BadgePiratesLLC/CactusCon-12/DOCS/ProjectNeoRogue_Back.png

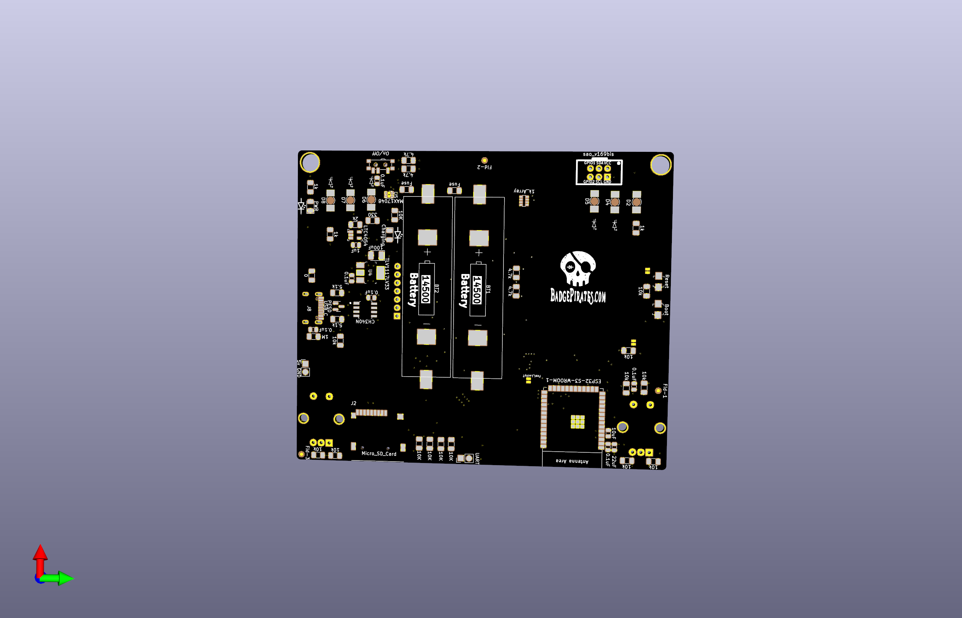
DOCS/ProjectNeoRogue_Back.png
