BadgePiratesLLC/CactusCon-12/DOCS/ProjectNeoRogue_Front.png

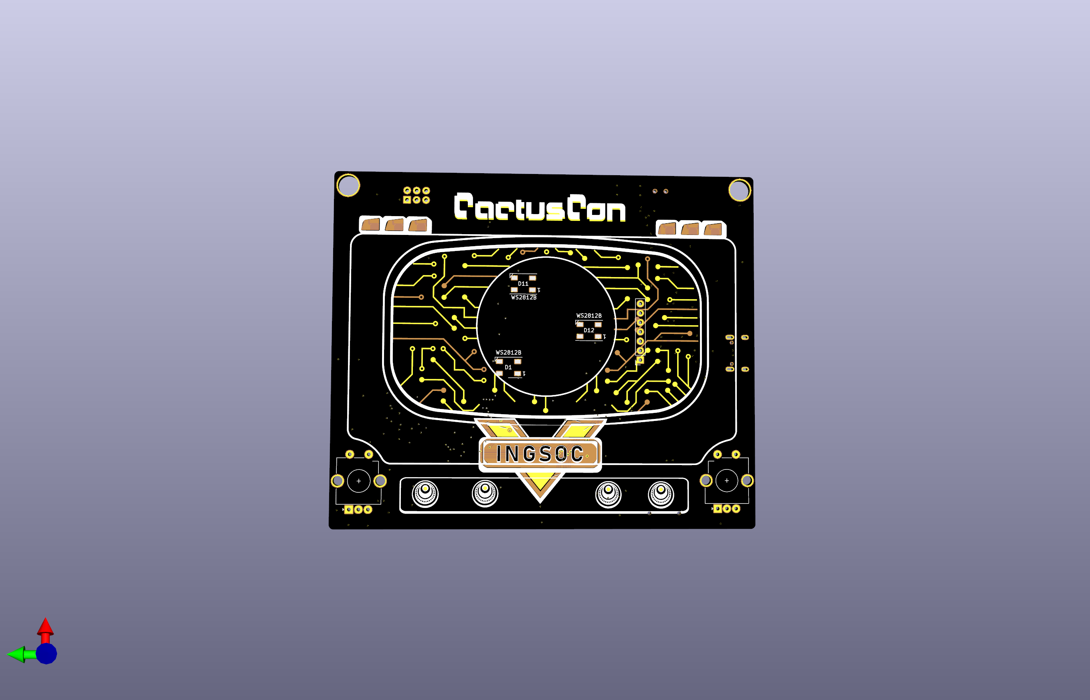
DOCS/ProjectNeoRogue_Front.png
