BadgePiratesLLC/CactusCon-12/Artwork/Export/.svg2shenzhen-cache/images/B.Cu_g3.png

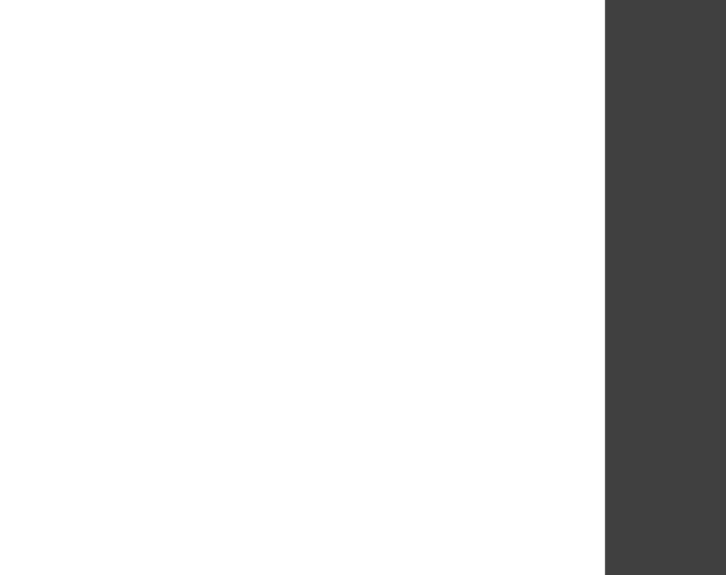
Artwork/Export/.svg2shenzhen-cache/images/B.Cu_g3.png
