BadgePiratesLLC/CactusCon-12/Artwork/Export/.svg2shenzhen-cache/images/Dwgs.User_g9.png

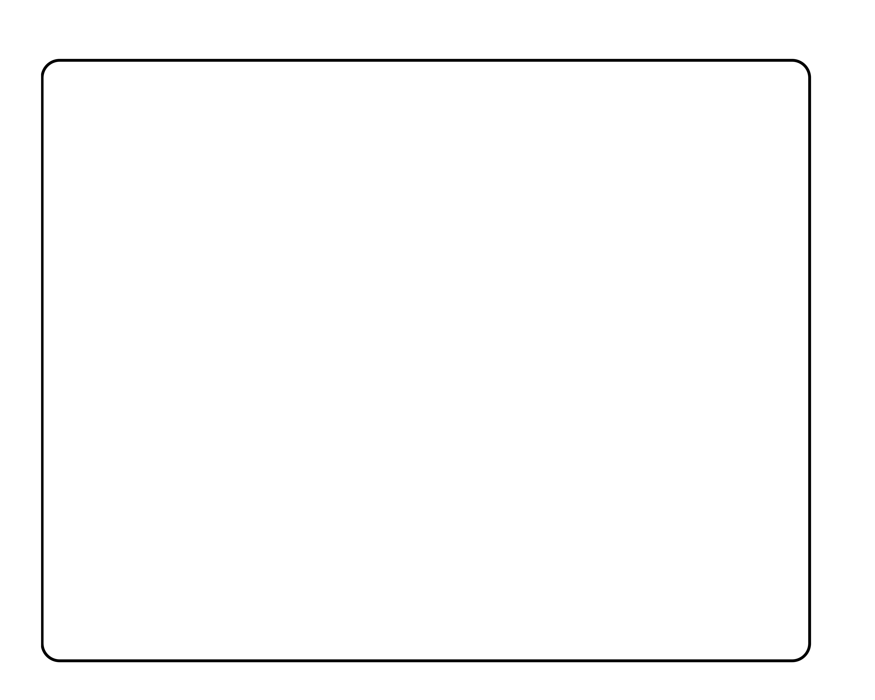
Artwork/Export/.svg2shenzhen-cache/images/Dwgs.User_g9.png
