BadgePiratesLLC/CactusCon-12/Artwork/Export/.svg2shenzhen-cache/images/F.SilkS_g8.png

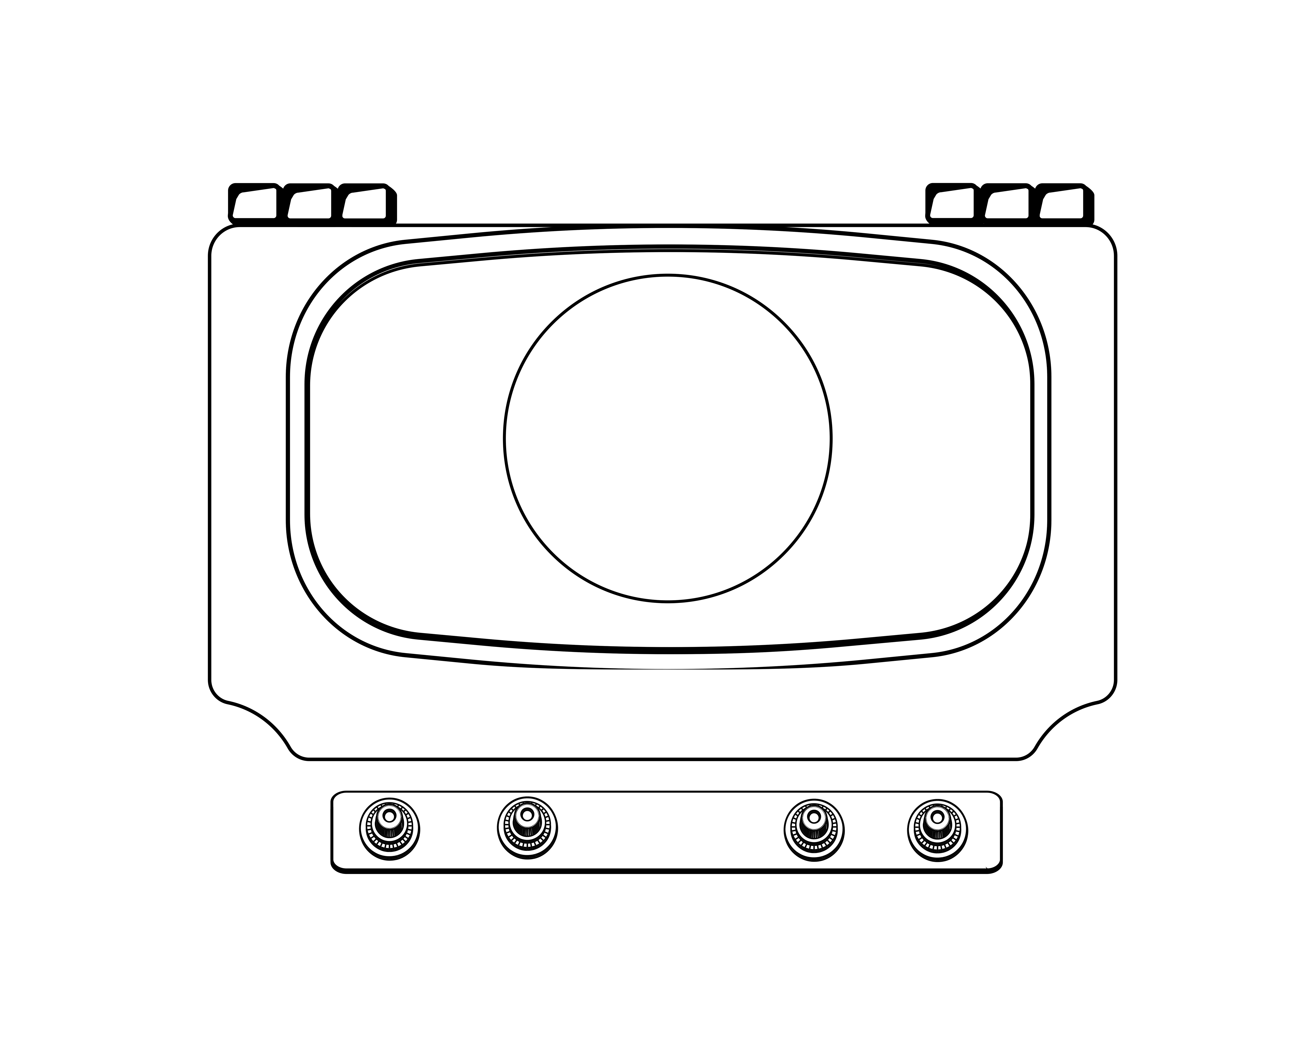
Artwork/Export/.svg2shenzhen-cache/images/F.SilkS_g8.png
