BadgePiratesLLC/CactusCon-12/Artwork/Export/Traces/.svg2shenzhen-cache/images/F.Cu_g3.png

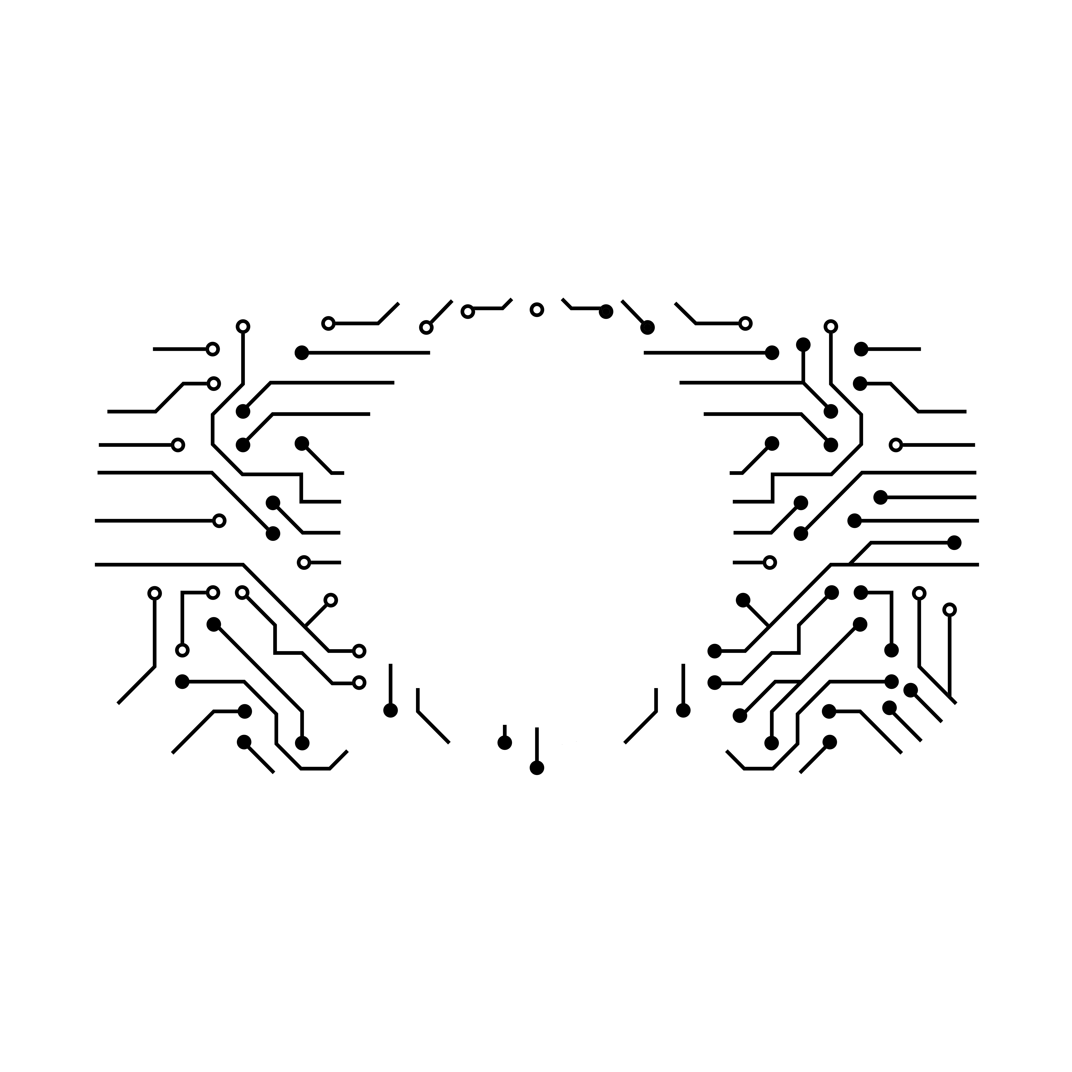
Artwork/Export/Traces/.svg2shenzhen-cache/images/F.Cu_g3.png
