BadgePiratesLLC/CactusCon-12/Artwork/LettersShadow/.svg2shenzhen-cache/images/F.Cu_g2.png

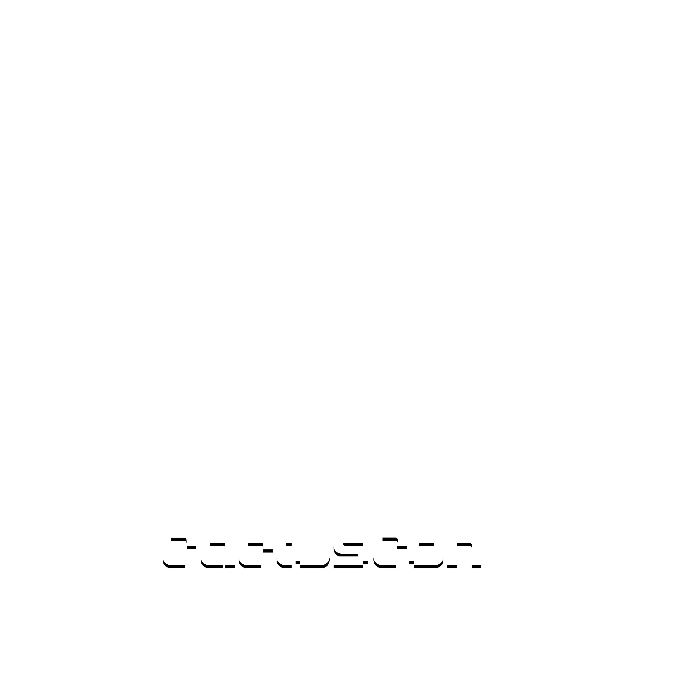
Artwork/LettersShadow/.svg2shenzhen-cache/images/F.Cu_g2.png
