BadgePiratesLLC/CactusCon-12/Artwork/LettersShadow/.svg2shenzhen-cache/images/F.Mask_g3.png

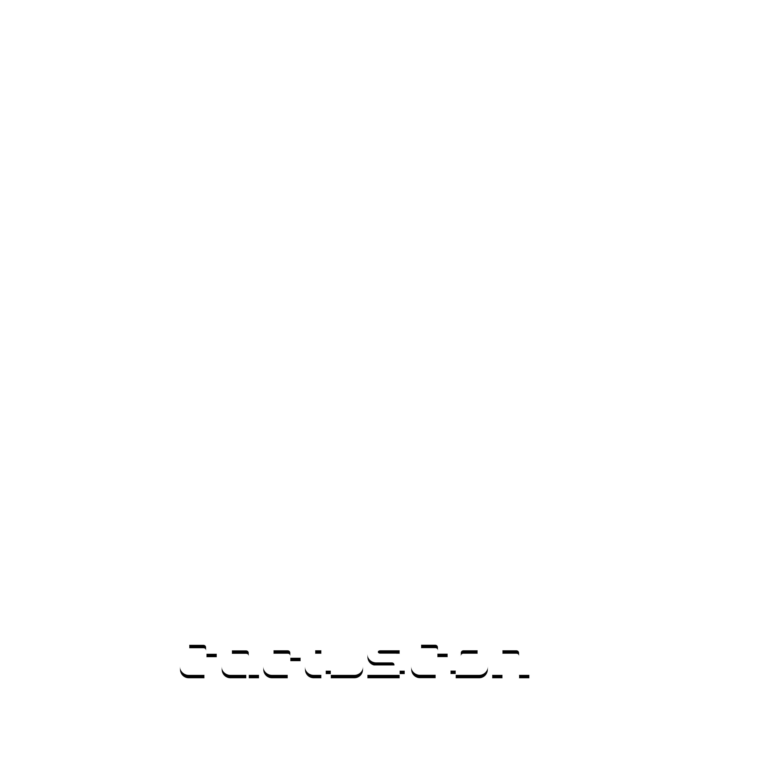
Artwork/LettersShadow/.svg2shenzhen-cache/images/F.Mask_g3.png
