BadgePiratesLLC/CactusCon-12/DOCS/CactusCon12_BOM.xlsx

null | Sourced | Placed | References | Value | Footprint | MFG | MFG_PN | OrderURL | Vendor1 | Vendor1_PN | Vendor1_URL | Quantity
1 |  |  | C1, C3, C5, C6, C8, C10 | 0.1uF | C_0805_2012Metric | TORCH | CT41G-0805-2X1-50V-0.1Î¼F-K(N) |  | LCSC | C126469 | https://www.lcsc.com/product-detail/Multilayer-Ceramic-Capacitors-MLCC-SMD-SMT_TORCH-CT41G-0805-2X1-50V-0-1-F-K-N_C126469.html | 6
2 |  |  | C2 | 1uF | C_0805_2012Metric | Samsung Electro-Mechanics | CL21B105KBFNNNE |  | LCSC | C28323 | https://www.lcsc.com/product-detail/Multilayer-Ceramic-Capacitors-MLCC-SMD-SMT_Samsung-Electro-Mechanics-CL21B105KBFNNNE_C28323.html | 1
3 |  |  | C4 | 22uF | C_0805_2012Metric | Samsung Electro-Mechanics | CL21A226MAYNNNE |  | LCSC | C602037 | https://www.lcsc.com/product-detail/Multilayer-Ceramic-Capacitors-MLCC-SMD-SMT_Samsung-Electro-Mechanics-CL21A226MAYNNNE_C602037.html | 1
4 |  |  | C7 | 100uF | 100uf_CP_Pad1.50x2.35mm | KYOCERA AVX | TAJB107M006RNJ |  | LCSC | C7195 | https://www.lcsc.com/product-detail/Tantalum-Capacitors_Kyocera-AVX-TAJB107M006RNJ_C7195.html | 1
5 |  |  | C9 | 10uF | C_0805_2012Metric | Samsung Electro-Mechanics | CL21A106KPCLQNC |  | LCSC | C962097 | https://www.lcsc.com/product-detail/Multilayer-Ceramic-Capacitors-MLCC-SMD-SMT_Samsung-Electro-Mechanics-CL21A106KPCLQNC_C962097.html | 1
6 |  |  | R4, R5, R6, R12, R13, R14, R15, R16, R17, R18, R19, R20, R29, R30 | 10k | R_1206_3216Metric | YAGEO | RC1206FR-0710KL |  | LCSC | C132649 | https://www.lcsc.com/product-detail/Chip-Resistor-Surface-Mount_YAGEO-RC1206FR-0710KL_C132649.html | 14
7 |  |  | R23, R26, R27, R28 | 4.7k | R_1206_3216Metric | YAGEO | RT1206FRE074K7L |  | LCSC | C872804 | https://www.lcsc.com/product-detail/Chip-Resistor-Surface-Mount_YAGEO-RT1206FRE074K7L_C872804.html | 4
8 |  |  | R1, R9, R25 | 1k | R_1206_3216Metric | YAGEO | RC1206FR-071KL |  | LCSC | C131398 | https://www.lcsc.com/product-detail/Chip-Resistor-Surface-Mount_YAGEO-RC1206FR-071KL_C131398.html | 3
9 |  |  | R10, R11 | 5.1k | R_1206_3216Metric | YEGEO | RC1206FR-075K1L |  | LCSC | C163372 | https://www.lcsc.com/product-detail/Chip-Resistor-Surface-Mount_YAGEO-RC1206FR-075K1L_C163372.html | 2
10 |  |  | R2 | 2k | R_1206_3216Metric | YAGEO | RC1206FR-072KL |  | LCSC | C133543 | https://www.lcsc.com/product-detail/Chip-Resistor-Surface-Mount_YAGEO-RC1206FR-072KL_C133543.html | 1
11 |  |  | R3 | 330 | R_1206_3216Metric | YAGEO | AC1206JR-07330KL |  | LCSC | C229929 | https://www.lcsc.com/product-detail/Chip-Resistor-Surface-Mount_YAGEO-AC1206JR-07330KL_C229929.html | 1
12 |  |  | R7 | 1M | R_1206_3216Metric | YAGEO | RC1206FR-071ML |  | LCSC | C108083 | https://www.lcsc.com/product-detail/Chip-Resistor-Surface-Mount_YAGEO-RC1206FR-071ML_C108083.html | 1
13 |  |  | R8 | 0 | R_1206_3216Metric | UNI-ROYAL(Uniroyal Elec) | 1206W4F0000T5E |  | LCSC | C17888 | https://www.lcsc.com/product-detail/Chip-Resistor-Surface-Mount_UNI-ROYAL-Uniroyal-Elec-1206W4F0000T5E_C17888.html | 1
14 |  |  | D2, D4, D5, D6, D7, D8 | LED | LED_Osram_Lx_P47F_D2mm_ReverseMount_Proper_Mask Only | KingBright | AA3528SYCKT09 |  | Mouser | 604-AA3528SYCKT09 | https://www.mouser.com/ProductDetail/Kingbright/AA3528SYCKT09?qs=PzGy0jfpSMsmUm0ELhsFuQ%3D%3D | 6
15 |  |  | D1, D11, D12 | WS2812B | LED_WS2812B_PLCC4_5.0x5.0mm_P3.2mm | Worldsemi | WS2812B-B/T |  | LCSC | C2761795 | https://www.lcsc.com/product-detail/Light-Emitting-Diodes-LED_Worldsemi-WS2812B-B-T_C2761795.html | 3
16 |  |  | D3 | Charging | LED_1206 | Foshan NationStar Optoelectronics | NCD1206B1 |  | LCSC | C130717 | https://www.lcsc.com/product-detail/Light-Emitting-Diodes-span-style-background-color-ff0-LED-span_Foshan-NationStar-Optoelectronics-NCD1206B1_C130717.html | 1
17 |  |  | D9 | PWR | LED_1206 | Foshan NationStar Optoelectronics | NCD1206C1 |  | LCSC | C84273 | https://www.lcsc.com/product-detail/Light-Emitting-Diodes-LED_Foshan-NationStar-Optoelectronics-NCD1206C1_C84273.html | 1
18 |  |  | D19 | PESD | SOT-23 | TECH PUBLIC | PESD2USB3UV-TR |  | LCSC | C7202955 | https://www.lcsc.com/product-detail/span-style-background-color-ff0-ESD-span-Protection-Devices_TECH-PUBLIC-PESD2USB3UV-TR_C7202955.html | 1
19 |  |  | U1 | LTC4054 | LTC4054 | TPOWER | TP4054ST25K |  | LCSC | TP4054ST25K | https://www.lcsc.com/product-detail/Battery-Management-ICs_TPOWER-TP4054ST25K_C382138.html | 1
20 |  |  | U2 | ESP32-S3-WROOM-1 | ESP32-S3-WROOM-1 | ESPRESSIF | ESP32-S3-WROOM-1-N8 |  | LCSC | C2913200 | https://www.lcsc.com/product-detail/WiFi-Modules_Espressif-Systems-ESP32-S3-WROOM-1-N8_C2913198.html | 1
21 |  |  | U3 | CH340N | SOIC-8-1EP_W3.9mm | WCH(Jiangsu Qin Heng) | CH340N |  | LCSC | C2977777 | https://www.lcsc.com/product-detail/USB-ICs_WCH-Jiangsu-Qin-Heng-CH340N_C2977777.html | 1
22 |  |  | U4 | TLV1117LV33 | SOT-223 | Texas Instruments | TLV1117LV33DCYR | https://www.lcsc.com/product-detail/_Texas-Instruments-_C15578.html | LCSC | C15578 | https://www.lcsc.com/product-detail/_Texas-Instruments-_C15578.html | 1
23 |  |  | U5 | MAX17048 | MAX17048_TDFN | Analog Devices Inc | MAX17048G+ |  | LCSC | C2682616 | https://www.lcsc.com/product-detail/Battery-Management-ICs_Analog-Devices-Inc-Maxim-Integrated-MAX17048G-T10_C2682616.html | 1
24 |  |  | F1, F2 | Fuse | R_1206_3216Metric | TLC Electronic | TLC-NSMD200 |  | LCSC | C261957 | https://www.lcsc.com/product-detail/Resettable-Fuses_TLC-Electronic-TLC-NSMD200_C261957.html | 2
25 |  |  | SW9, SW10 | RotaryEncoder_Switch | RotaryEncoder_Alps_EC11E-Switch_Vertical_H20mm_CircularMountingHoles | ALPSALPINE | EC11E1820402 |  | LCSC | C361167 | https://www.lcsc.com/product-detail/Rotary-Encoders_ALPSALPINE-EC11E1820402_C361167.html | 2
26 |  |  | SW1 | On/Off | SW_SPDT_PCM12 | ALPSALPINE | SSSS811101 |  | LCSC | C109335 | https://www.lcsc.com/product-detail/Slide-Switches_ALPSALPINE-SSSS811101_C109335.html | 1
27 |  |  | SW2 | Boot | Switch_Tactile_SMD_B3U-1000P-BPVersion | Omron Electronics | B3U-1000P |  | LCSC | C231329 | https://www.lcsc.com/product-detail/_Omron-Electronics-_C231329.html | 1
28 |  |  | SW3 | Reset | Switch_Tactile_SMD_B3U-1000P-BPVersion | Omron Electronics | B3U-1000P |  | LCSC | C231329 | https://www.lcsc.com/product-detail/_Omron-Electronics-_C231329.html | 1
31 |  |  | BT1, BT2 | Battery | Battery - 14500 | Keystone Electronics | 53 |  | DigiKey | 36-53-ND | https://www.digikey.com/en/products/detail/keystone-electronics/53/2745544 | 4
40 |  |  | RN2 | 1k_Array | R_Array_Convex_4x0603 | YAGEO | YC164-JR-071KL |  | LCSC | C93675 | https://www.lcsc.com/product-detail/Resistor-Networks-Arrays_YAGEO-YC164-JR-071KL_C93675.html | 1
41 |  |  | J2 | Micro_SD_Card | TF_PUSH | SHOU HAN | TF PUSH |  | LCSC | C393941 | https://www.lcsc.com/product-detail/SD-Card-Connectors_SHOU-HAN-TF-PUSH_C393941.html | 1
42 |  |  | J7 | RoundDisplay_SPI | PinSocket_1x07_P2.54mm_Vertical |  |  |  |  |  | https://www.aliexpress.us/item/3256805864860787.html?curPageLogUid=xqQ5ECtYNWfW | 1
43 |  |  | J8 | USB_C | USB_C_Receptical-Jing | Jing Extension of the Electronic Co. | 918-418K2023S40019 |  | LCSC | C709035 | https://www.lcsc.com/product-detail/USB-Connectors_Jing-Extension-of-the-Electronic-Co-918-418K2023S40019_C709035.html | 1
