BadgePiratesLLC/CactusCon-12/(commit log)

2023-10-25 adding CAD
    [ESP32-S3_PinOut_Prospect_v3.xlsx, LEDs.kicad_sch, Max17048.kicad_sch, ProjectNeoRogue.kicad_pcb, ProjectNeoRogue.kicad_sch, RotaryEncoders.kicad_sch, Screens.kicad_sch, USB_Connections.kicad_sch]
2023-10-26 Added new MAX17048
    Added new MAX17048 symbol and wired up hierarchical block
    [Max17048.kicad_sch, ProjectNeoRogue.kicad_sch]
2023-10-30 adding footprints and starting to route
    [ESP32-S3_PinOut_Prospect_v3.xlsx, ESP32-S3_PinOut_v3.xlsx, Max17048.kicad_sch, ProjectNeoRogue.kicad_pcb, Screens.kicad_sch]
2023-10-31 placing parts
    [Max17048.kicad_sch, ProjectNeoRogue.kicad_pcb]
2023-10-31 Sheet Info Updated
    Updating Status Sheet Info
    [ProjectNeoRogue.kicad_pcb, ProjectNeoRogue.kicad_sch]
2023-10-31 Updated SD Card holder information
    Updated SD Card holder info with part numbers and datasheet. Removed footprint into. TODO create new footprint for SD card holder SHOU HAN TF PUSH
    [ProjectNeoRogue.kicad_sch]
2023-10-31 Added JTAG terminations
    Added JTAG terminations and pullups per https://www.jtag.com/wp-content/uploads/2019/04/0020-Board-DFT-E-1.pdf
    [ProjectNeoRogue.kicad_sch]
2023-10-31 Removed RN1
    Removed RN1 since only one value was used. Changed to single 1k resistor
    [LEDs.kicad_sch]
2023-10-31 Moved power circuits to their own sheet
    Moved the power circuits to their own sheet
    [Max17048.kicad_sch, Power.kicad_sch, ProjectNeoRogue.kicad_sch]
2023-10-31 Schematic cleanup
    [Power.kicad_sch]
2023-10-31 Added Tag Connect for JTAG
    [Power.kicad_sch, ProjectNeoRogue.kicad_pcb, ProjectNeoRogue.kicad_sch]
2023-10-31 Layout progress
    [Max17048.kicad_sch, Power.kicad_sch, ProjectNeoRogue.kicad_pcb, ProjectNeoRogue.kicad_sch, RotaryEncoders.kicad_sch, USB_Connections.kicad_sch]
2023-11-01 Update board stack up and netclass assignment
    [ProjectNeoRogue.kicad_pcb, USB_Connections.kicad_sch]
2023-11-04 routing and removing buttons OLED
    [ProjectNeoRogue-B_Cu.gbr, ProjectNeoRogue-B_Mask.gbr, ProjectNeoRogue-B_Silkscreen.gbr, ProjectNeoRogue-Edge_Cuts.gbr, ProjectNeoRogue-F_Cu.gbr, ProjectNeoRogue-F_Mask.gbr, ProjectNeoRogue-F_Silkscreen.gbr, ProjectNeoRogue-In1_Cu.gbr]
2023-11-04 Update ProjectNeoRogue.kicad_sch
    Corrected SD card footprint and updated symbol to match the SD card
    [ProjectNeoRogue.kicad_sch]
2023-11-04 Update ProjectNeoRogue.kicad_sch
    Added pin connection for TDI incase we need it
    [ProjectNeoRogue.kicad_sch]
2023-11-04 Fixed no connect symbols on SD card.
    Not needed for routing but will help with error checking the schematic.
    [ProjectNeoRogue.kicad_sch]
2023-11-04 routing and cleanup
    [ESP32-S3_PinOut_v3.xlsx, ProjectNeoRogue.kicad_pcb, ProjectNeoRogue.kicad_sch]
2023-11-04 Updated pin usage
    Removed Up/Dn/L/R/Mid buttons
    [ESP32-S3_PinOut_v3.xlsx]
2023-11-04 Update ESP32-S3_PinOut_v3.xlsx
    Move TFT to its own bus
    [ESP32-S3_PinOut_v3.xlsx]
2023-11-04 Update ESP32-S3_PinOut_v3.xlsx
    Updated encoder switch GPIO PIN
    [ESP32-S3_PinOut_v3.xlsx]
2023-11-04 Updated pins and moar
    [Power.kicad_sch, ProjectNeoRogue.kicad_pcb, ProjectNeoRogue.kicad_sch, RotaryEncoders.kicad_sch, Screens.kicad_sch]
2023-11-04 Updated layout
    [ProjectNeoRogue.kicad_pcb, ProjectNeoRogue.kicad_sch]
2023-11-04 Made sheet settings path relative to the project
    [LEDs.kicad_sch, Max17048.kicad_sch, Power.kicad_sch, RotaryEncoders.kicad_sch, Screens.kicad_sch, USB_Connections.kicad_sch]
2023-11-04 Create ibom.config.ini
    BOM settings file stored locally with the project
2023-11-04 Updated part property names
    Made part property names uniform
    [Power.kicad_sch, ProjectNeoRogue.kicad_sch, USB_Connections.kicad_sch]
2023-11-04 Create ibom.html
    Created BOM
2023-11-04 Fixed IO pins
    [ESP32-S3_PinOut_v3.xlsx, ProjectNeoRogue.kicad_sch, Screens.kicad_sch]
2023-11-04 Routing progress
    [ProjectNeoRogue.kicad_pcb]
2023-11-04 fixing part numbers info on some parts
    ESP, 340N, R330
    [Power.kicad_sch, ProjectNeoRogue.kicad_sch, USB_Connections.kicad_sch]
2023-11-04 removing some things from BOM that were DNP
    [ProjectNeoRogue.kicad_sch, Screens.kicad_sch]
2023-11-04 Layout ready for cleanup
    [ProjectNeoRogue.kicad_pcb]
2023-11-05 gerbers and logos
    [Power.kicad_sch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]
2023-12-09 artwork work
    [ProjectNeoRogue.kicad_pcb]
2023-12-09 adding artwork
    [ProjectNeoRogue.kicad_pcb]
2023-12-09 adding art
    [ESP32-S3_PinOut_v3.xlsx, Power.kicad_sch, ProjectNeoRogue.kicad_pcb, ProjectNeoRogue.kicad_sch, Screens.kicad_sch]
2023-12-09 cleanup and screen shots of 3d View
    [ProjectNeoRogue.kicad_pcb]
2023-12-11 Gerbers and BOM
    [ESP32-S3_PinOut_v3.xlsx, Power.kicad_sch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]
2024-01-25 working on code
    [ProjectNeoRogue-B_Cu.gbr, ProjectNeoRogue-B_Mask.gbr, ProjectNeoRogue-B_Silkscreen.gbr, ProjectNeoRogue-Edge_Cuts.gbr, ProjectNeoRogue-F_Cu.gbr, ProjectNeoRogue-F_Mask.gbr, ProjectNeoRogue-F_Silkscreen.gbr, ProjectNeoRogue-In1_Cu.gbr]
2024-01-25 fixing pin numbers
2024-02-21 Cleaning up
    [CactusCon12.kicad_pcb, CactusCon12.kicad_sch, CactusCon12_BOM.xlsx, LEDs.kicad_sch, Max17048.kicad_sch, Power.kicad_sch, RotaryEncoders.kicad_sch, Screens.kicad_sch]
2024-02-21 removed code, added in some led + screen test, and improved OTA code
